PeteHorn/labview-car/CTI-Grove/Documentation/PCB/Radxa X4 Grove Base Hat V1_1/Radxa X4 Grove Base Hat V1_1.kicad_pcb

## KiCad design CTI-Grove/Documentation/PCB/Radxa X4 Grove Base Hat V1_1/Radxa X4 Grove Base Hat V1_1.kicad_pcb (2026-05-17)

Schematic: Radxa X4 Grove Base Hat V1_1.kicad_sch

Parts:
FR2: SEEEDSTUDIO-OPEN-SCH-FRAME; SEEEDSTUDIO-PCB-FRAME
J1: PIN_PITCH_2.54MM_2X3; PIN6_PITCH_2.54MM_2X3
J2, J3, J4, J5, J6, J9, J10, J11, J12, J14: 4P-2.0;320110030; 4P-2.0
SW1: 6P-2CH-2.5-9.1X3.5X3.2H-90D
U2: 2x20 2.54; RASPI_BOARD_B+HAT_DF_CF

Connections:
/3V3_GROVE: J1.2, J3.3, J4.3, J12.3, SW1.CH1A, SW1.CH2A, U2.1 (3V3@1), U2.17 (3V3@2)
/5V_GROVE: SW1.CH1B, SW1.CH2B, U2.2 (5V0@1)
/5V_Grove: U2.4 (5V0@2)
/GPIO2_Rp2040: J1.6, U2.38 (GPIO2)
/GPIO3_Rp2040: J1.5, U2.15 (GPIO3)
/GPIO4_Rp2040: J1.4, J11.2, U2.7 (GPIO4)
/GPIO5_Rp2040: J1.3, J11.1, U2.11 (GPIO5)
/GPIO6_Rp2040: J10.2, U2.13 (GPIO6)
/GPIO7_Rp2040: J10.1, U2.29 (GPIO7)
/GPIO8_Rp2040: J9.2, U2.21 (GPIO8)
/GPIO9_Rp2040: J9.1, U2.24 (GPIO9)
/GPIO10_Rp2040: U2.23 (GPIO10)
/GPIO11_Rp2040: U2.19 (GPIO11)
/GPIO12_Rp2040: J14.2, U2.31 (GPIO12)
/GPIO13_Rp2040: J14.1, U2.33 (GPIO13)
/GPIO14_Rp2040: U2.37 (GPIO14)
/GPIO15_Rp2040: U2.35 (GPIO15)
/GPIO16_Rp2040: J2.1, U2.27 (GPIO16)
/GPIO17_Rp2040: J2.2, U2.28 (GPIO17)
/GPIO18_Rp2040: J5.1, U2.26 (GPIO18)
/GPIO19_Rp2040: J5.2, U2.32 (GPIO19)
/GPIO20_Rp2040: J6.1, U2.8 (GPIO20)
/GPIO21_Rp2040: J6.2, U2.10 (GPIO21)
/GPIO22_Rp2040: U2.16 (GPIO22)
/GPIO23_Rp2040: U2.12 (GPIO23)
/GPIO24_Rp2040: U2.22 (GPIO24)
/GPIO25_Rp2040: U2.40 (GPIO25)
/GPIO26_Rp2040: J4.2, J12.1, U2.36 (GPIO26)
/GPIO27_Rp2040: J3.2, J4.1, U2.18 (GPIO27)
/GPIO28_Rp2040: J3.1, U2.3 (GPIO28)
/GPIO29_Rp2040: U2.5 (GPIO29)
/NC: J12.2
/VCC: J2.3, J5.3, J6.3, J9.3, J10.3, J11.3, J14.3, SW1.COM1, SW1.COM2
GND_POWER: J1.1, J2.4, J3.4, J4.4, J5.4, J6.4, J9.4, J10.4, J11.4, J12.4, J14.4, U2.6 (GND@1), U2.9 (GND@2), U2.14 (GND@3), U2.20 (GND@4), U2.25 (GND@5), U2.30 (GND@6), U2.34 (GND@7), U2.39 (GND@8)

Notes on the sheet:
ADC (A2)
ADC (A1)
SCL
Vincent
UART0
GPIO (D20)
ADC (A0)
2018/7/24
Initial release
GPIO (D16)
UART1
I2C1
SDA
v1.0
GPIO (D18)
I2C0

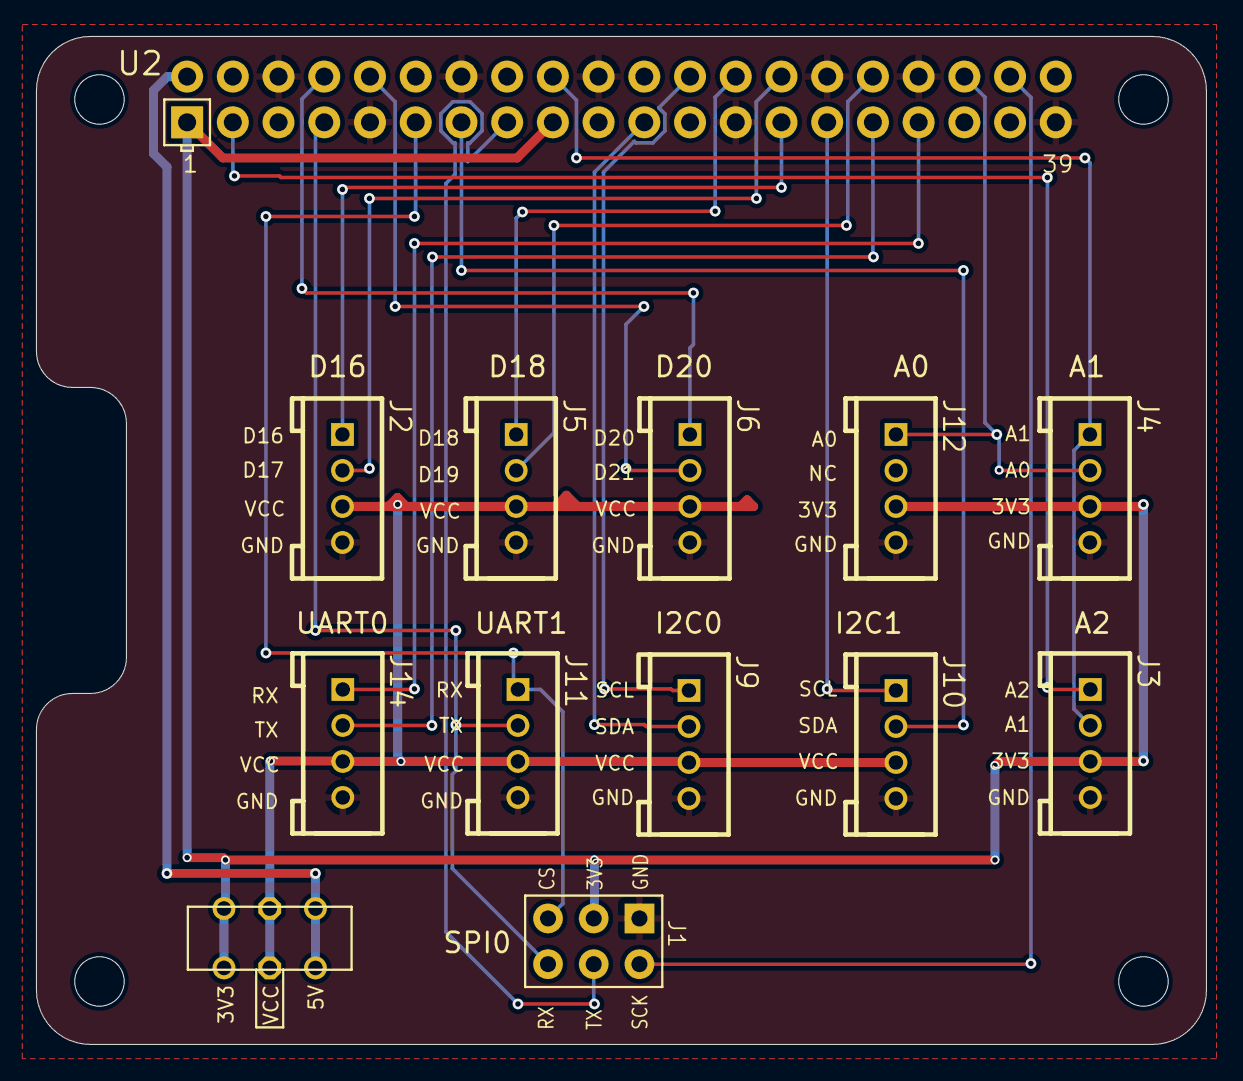
[picture p2: board Radxa X4 Grove Base Hat V1_1.kicad_pcb from above]

Board: 2 copper layers, 65.0 x 56.0 mm, 14 parts (0 on the bottom side), 23 nets.
