PeteHorn/labview-car/CTI-Grove/Documentation/Tests/2025-306TST0001(Functional Tests for Grove Boards).odt

Document Change History

Version Number | Date | Contributor | Description
V1.00 | 28/04/2025 | TBD | 1st Issue

# Introduction

This document describes the tests and equipment completed on CTI PICO VISA version 0.92 (0.9.2.20250429T155747Z)

It has been specifically tested with the Grove hardware, links will be in each test.

Pico | COM Port
503558607AC5769F | 17

# Dual Buttons

Tested digital inputs on GPIO 16,17,18,19,20,21

# 1602 LCD (I2C)

RawI2CLCD1602.vi

## I2C0 Connector

Switch Set to 3V3 and 5V

Bus = 1

Baud = 400000

SCL GPIO = 8

SDA GPIO = 9

Errors with error -1073807360 – unknown system error (miscellaneous error)

VISA Write in CTI-Visa.lvlib:Write I2C.vi→RawI2CLCD1602Demo.vi

Pico LED is solidly on

Bus 1,2,3 run (but nothing seen on LCD), 4 throws same error as 0

## I2C1 Connector

Switch Set to 3V3 and 5V works

Bus = 1

Baud = 400000

SCL GPIO = 6

SDA GPIO = 7

Tested and works

# Sound Sensor

SoundSensor.vi

Connector A0 – Works OK

Connector A1 – Works OK

Connector A2 – Works OK

# Gesture Sensor

GestureSensor PAJ7620U2.vi

Works on I2C0 and I2C1

# Analog Output

# Digital Output

LEDSocketKit.vi

GPIO 16,18, 20

SSDC Limited Description Functional Tests for Grove Boards Issue 1:00 Date 28/04/2025 Document Number 2025-306TST0001

Page 3 of 3 C:\Users\Public\CTI\CTI-Grove\Documentation\Tests\2025-306TST0001(Functional Tests for Grove Boards).odt
