PeteHorn/labview-car/(commit log)

2026-05-17 added in the cti-grove examples and built a small poc for the car, motor's working forward direction only. Started building an actor for motor control
    [Radxa X4 Grove Base Hat V1_1.kicad_pcb, Radxa X4 Grove Base Hat V1_1.kicad_sch, Radxa X4 Grove Base HatBackup.kicad_sch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]
2026-05-18 rebuilt the firmware so that the odd numbered channels work - now have the motor test working
2026-07-25 Started LED Matrix module
    Started work on the LED matrix module. Defined 2d arrays for capitol letters, and built some code to create the correct hex values. Still copy paste in to the ardiuno code for the moment. Will need to update the pi firmware to control it through LV
2026-08-18 have the poc working for the led matrix, will work on the proper way of interacting with it next
2026-08-18 neatening up the poc a bit for the led matrix
2026-08-19 Building LED Matrix class and content
    Working on the subclasses of content type, starting with text but plan to add images and animations too
2026-08-20 LED Matrix Actor
    Working on the text class and trying to keep as much generic functionality as possible
