PeteHorn/labview-car/(notices)

Notices in the files:
CTI-Grove/Documentation/PCB/Radxa X4 Grove Base Hat V1_1/Radxa X4 Grove Base Hat V1_1.kicad_sch:
CC-BY-SA
parts and their libraries:
This work is licensed under the Creative Commons Attribution 4.0 International License.
To view a copy of this license,visit:
http://creativecommons.org/licenses/by-sa/4.0
